zuo337/tiangongqiaoxin/README.md

# tiangongqiaoxin
v\created by CRTC team_tiangongqiaoxin
