zuo337/tiangongqiaoxin/docx/附件/硬件/6DBB50F2CB37CF3823696F736B00C949.jpg

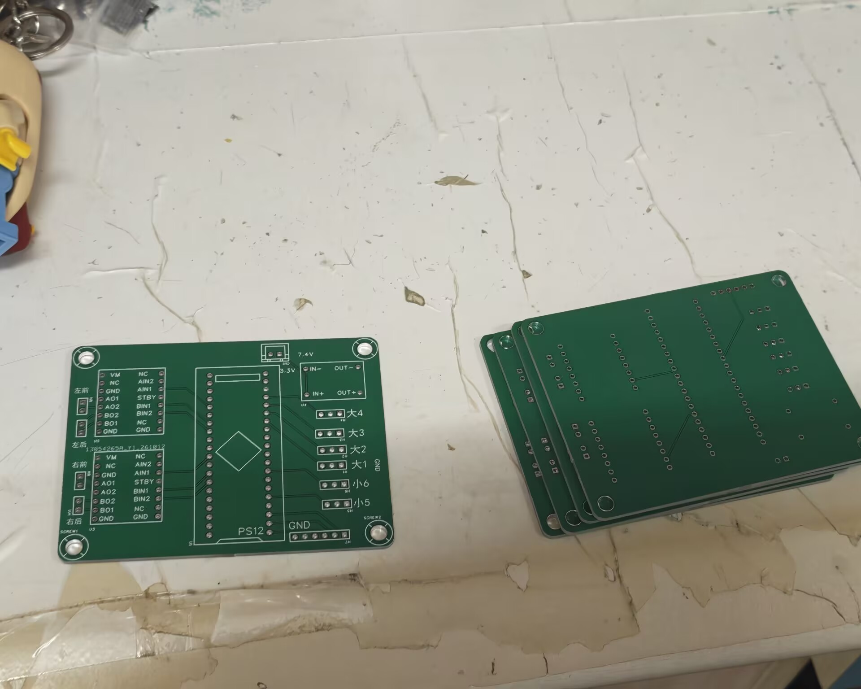
docx/附件/硬件/6DBB50F2CB37CF3823696F736B00C949.jpg
