zuo337/tiangongqiaoxin/docx/附件/硬件/B3D44D2F04DBA8AD3EAA5640361EBDE6.jpg

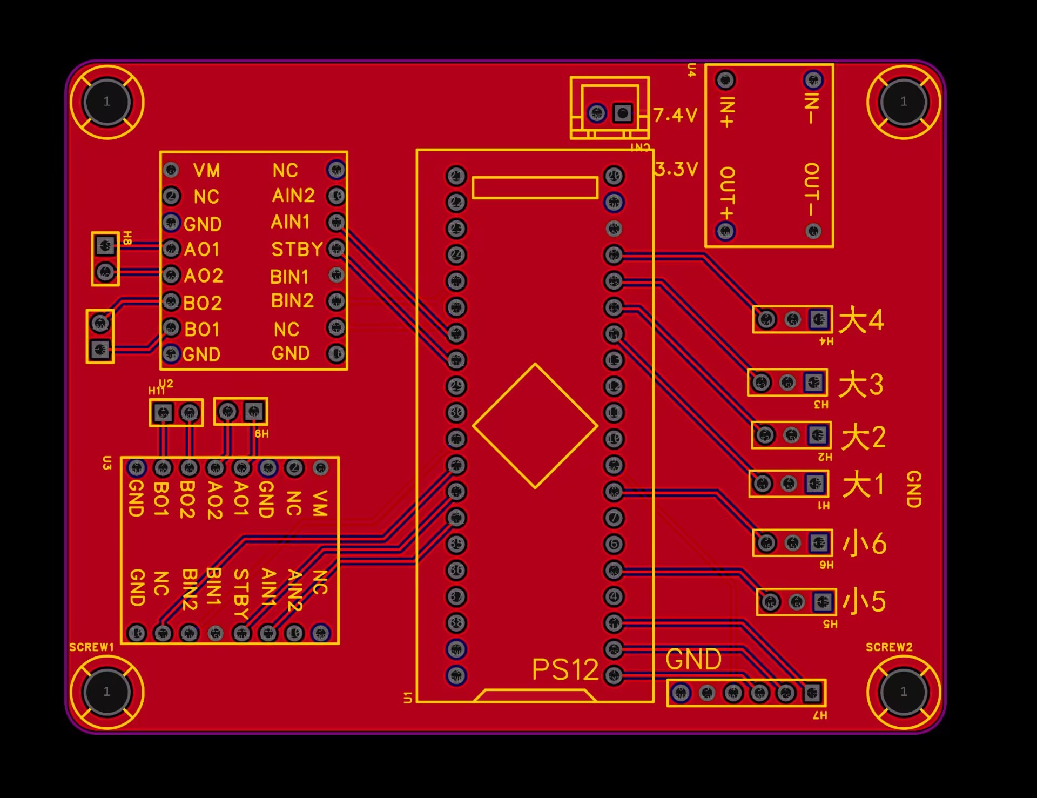
docx/附件/硬件/B3D44D2F04DBA8AD3EAA5640361EBDE6.jpg
