zuo337/tiangongqiaoxin/docx/附件/硬件/C09552E573FA0FD2E529ECBFBEFBE741.jpg

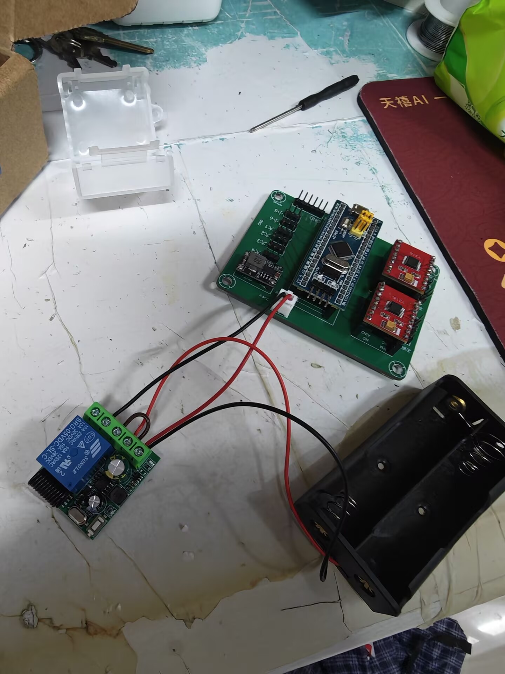
docx/附件/硬件/C09552E573FA0FD2E529ECBFBEFBE741.jpg
