zuo337/tiangongqiaoxin/docx/附件/机械/零部件1.step

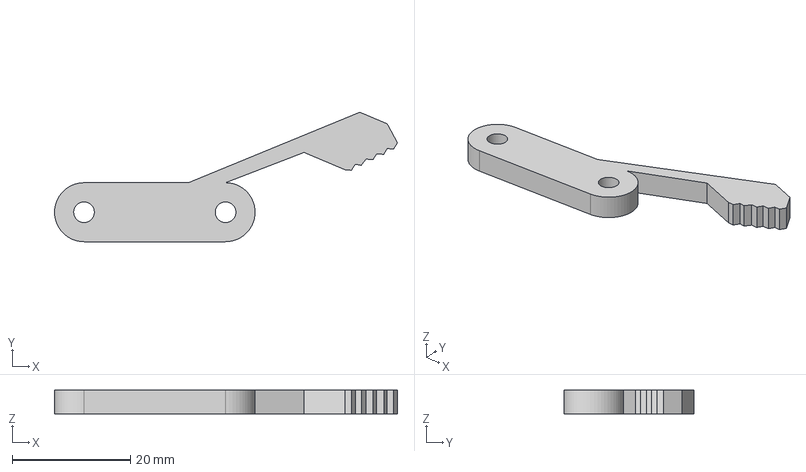
[picture p7: CAD file, 2026-10-18]
docx/附件/机械/零部件1.step
58.1 x 21.9 x 4.00 mm
