zuo337/tiangongqiaoxin/docx/附件/机械/L型支架.step

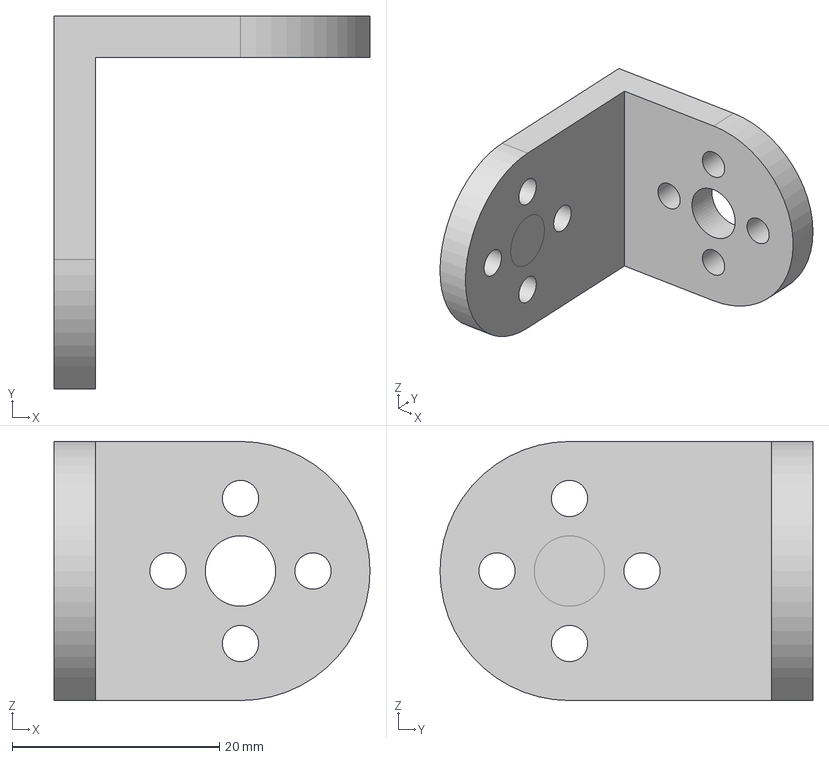
[picture p8: CAD file, 2026-10-18]
docx/附件/机械/L型支架.step
30.5 x 36.0 x 25.0 mm
