zuo337/tiangongqiaoxin/docx/附件/机械/零部件31.step

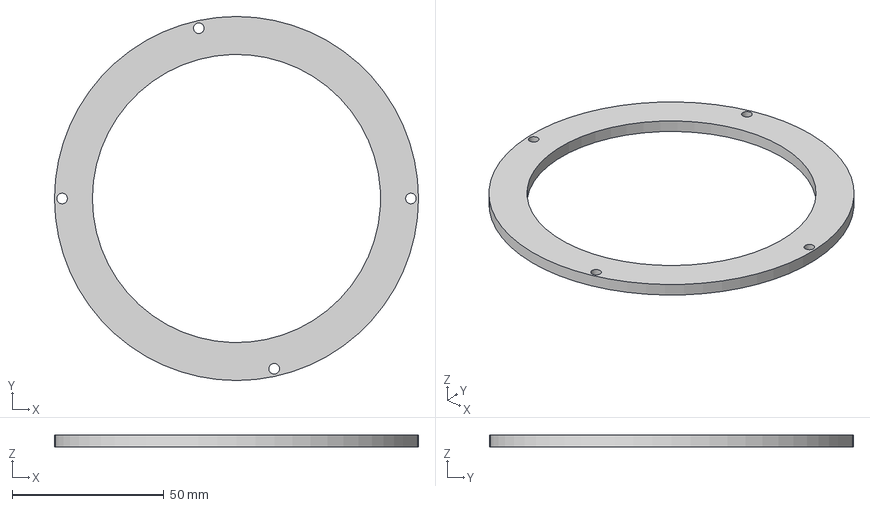
[picture p9: CAD file, 2026-10-18]
docx/附件/机械/零部件31.step
120.0 x 120.0 x 4.00 mm
