zuo337/tiangongqiaoxin/docx/附件/机械/零部件30.step

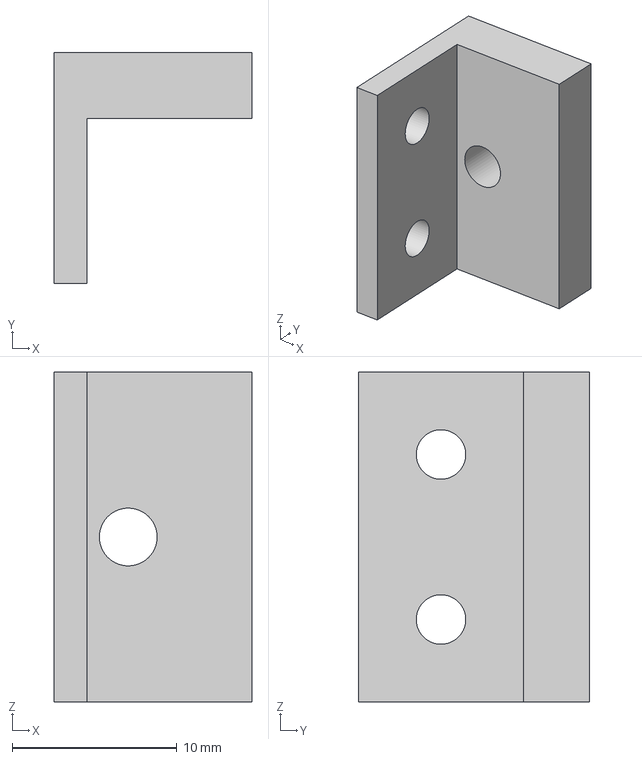
[picture p10: CAD file, 2026-10-18]
docx/附件/机械/零部件30.step
12.0 x 14.0 x 20.0 mm
