zuo337/tiangongqiaoxin/docx/附件/机械/Spur Gear 24 teeth.step

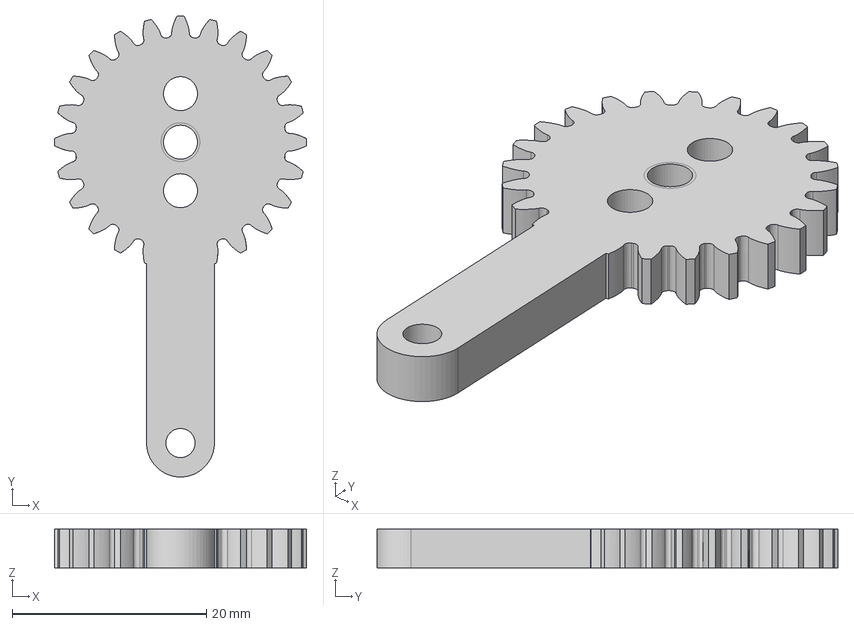
[picture p11: CAD file, 2026-10-18]
docx/附件/机械/Spur Gear 24 teeth.step
26.0 x 47.5 x 4.00 mm
