zuo337/tiangongqiaoxin/docx/附件/机械/多功能支架.step

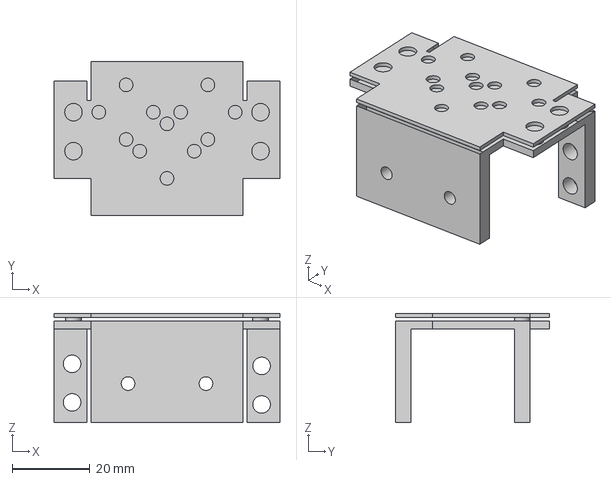
[picture p12: CAD file, 2026-10-18]
docx/附件/机械/多功能支架.step
58.0 x 39.5 x 28.0 mm
