zuo337/tiangongqiaoxin/docx/附件/机械/零部件29.step

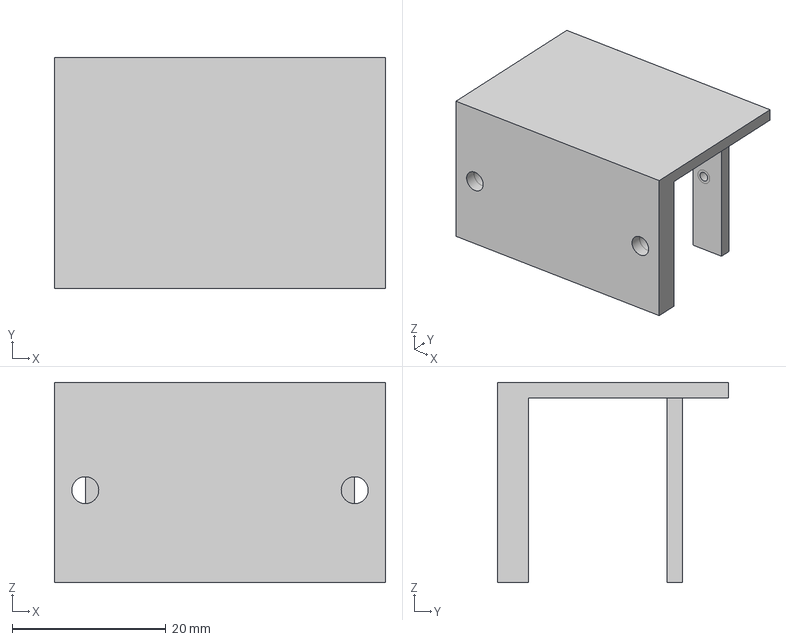
[picture p13: CAD file, 2026-10-18]
docx/附件/机械/零部件29.step
43.0 x 30.0 x 26.0 mm
