zuo337/tiangongqiaoxin/docx/附件/机械/零部件3.step

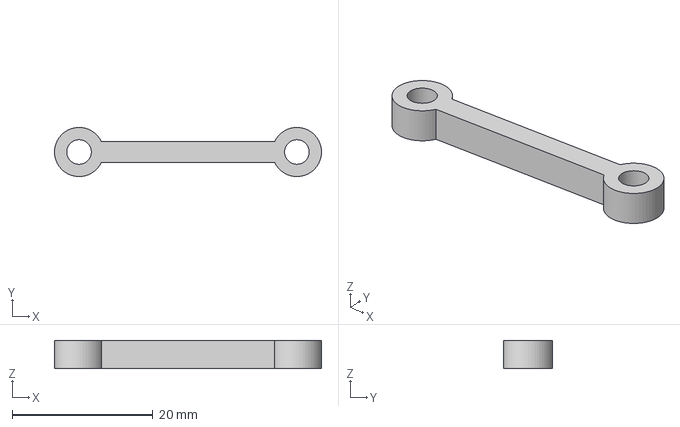
[picture p14: CAD file, 2026-10-18]
docx/附件/机械/零部件3.step
38.0 x 7.00 x 4.00 mm
