zuo337/tiangongqiaoxin/docx/附件/机械/长U型支架.step

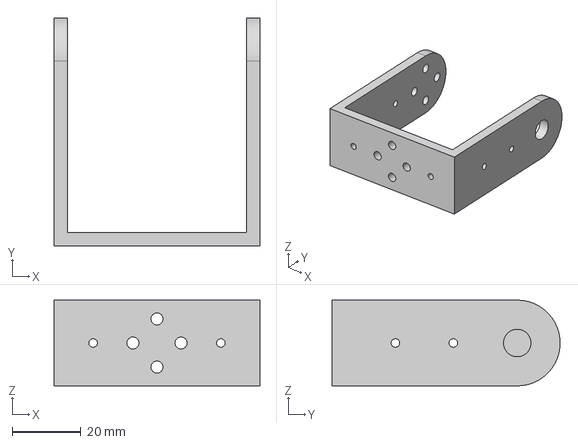
[picture p15: CAD file, 2026-10-18]
docx/附件/机械/长U型支架.step
60.0 x 66.5 x 25.0 mm
