zuo337/tiangongqiaoxin/docx/附件/机械/零部件19.step

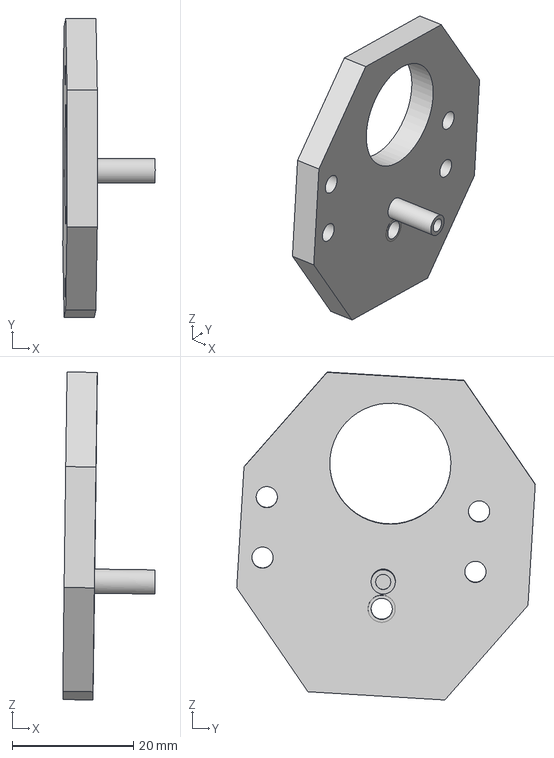
[picture p16: CAD file, 2026-10-18]
docx/附件/机械/零部件19.step
15.3 x 49.3 x 54.2 mm
