zuo337/tiangongqiaoxin/docx/附件/机械/零部件16.step

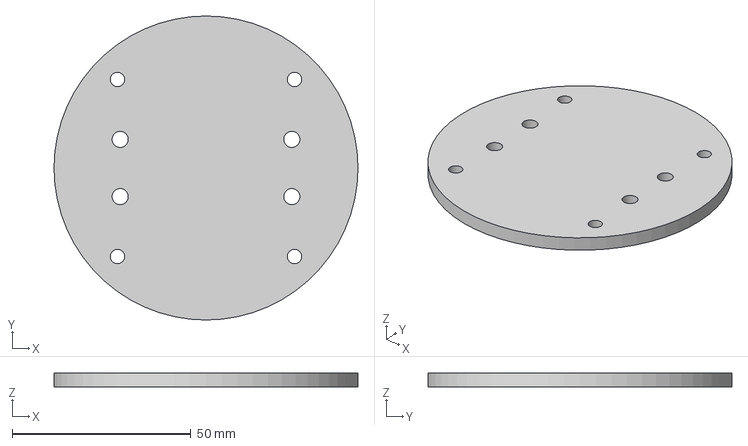
[picture p18: CAD file, 2026-10-18]
docx/附件/机械/零部件16.step
85.0 x 85.0 x 4.00 mm
