zuo337/tiangongqiaoxin/(list of files, cad)

Other CAD files:
docx/附件/机械/零部件15.step
docx/附件/机械/零部件2.step
