zuo337/tiangongqiaoxin/(commit log)

2026-10-18 附件：硬件图片与电控代码
2026-10-18 附件：机械 3D 模型（step）
    [L型支架.step, Spur Gear 24 teeth.step, 多功能支架.step, 长U型支架.step, 零部件1.step, 零部件14.step, 零部件15.step, 零部件16.step]
2026-10-18 附件：功能视频-四舵机转动
2026-10-18 附件：功能视频-底盘运动
2026-10-18 附件：功能视频-电机运动
2026-10-18 附件：功能视频-结构稳定性
2026-10-18 附件：功能视频-外形展示
2026-10-18 整理目录：把 tiangongqiaoxin.md 与 附件 移入 docx 文件夹
    [L型支架.step, Spur Gear 24 teeth.step, 多功能支架.step, 长U型支架.step, 零部件1.step, 零部件14.step, 零部件15.step, 零部件16.step]
2026-10-18 文档：尺寸规范图片改为仓库内相对路径 (images/)
2026-10-18 文档：五处视频说明改为可点击的相对链接
