zuo337/tiangongqiaoxin/(notices)

Notices in the files:
docx/附件/电控/core/Src/main.c:
Copyright (c) 2026 STMicroelectronics.
All rights reserved.
This software is licensed under terms that can be found in the LICENSE file
